hpzhaozhao/LZU_ASCENTO/dm-mc02-master/LCD模块/DM_TFT-V1.1.step

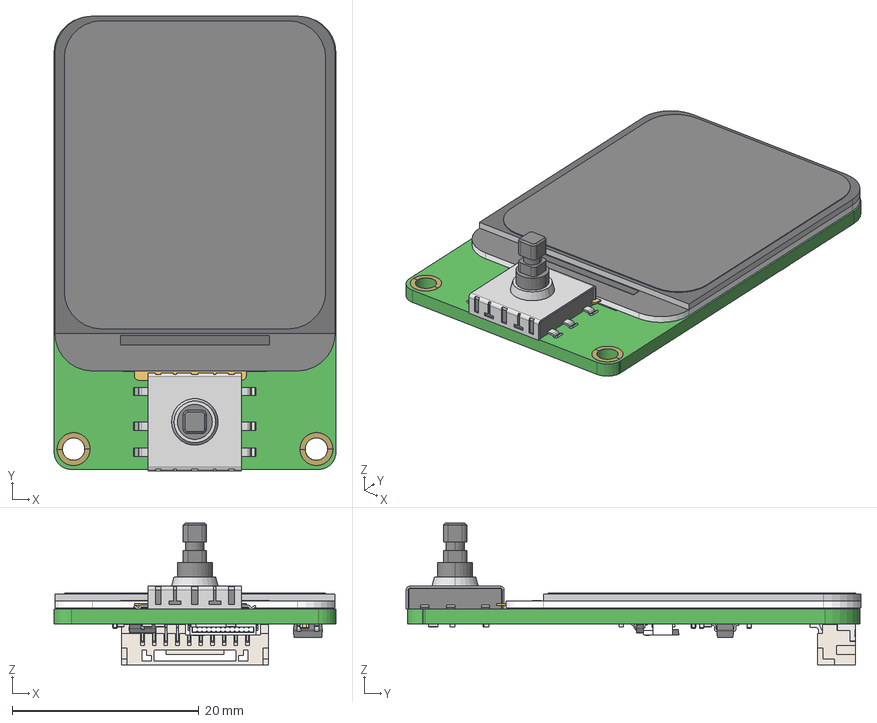
[picture p43: CAD file, 2026-05-26]
dm-mc02-master/LCD模块/DM_TFT-V1.1.step
30.2 x 48.7 x 15.2 mm
K1-1504SA-06 x 24
Extruded x 38
User Library-SOT23A
COMPOUND.step
R0402 x 12
sot-23-3-infineon
1.69¡± Round IPS x 57
SOLID.step
