hpzhaozhao/LZU_ASCENTO/答辩ppt/赵锦程答辩ppt.pdf

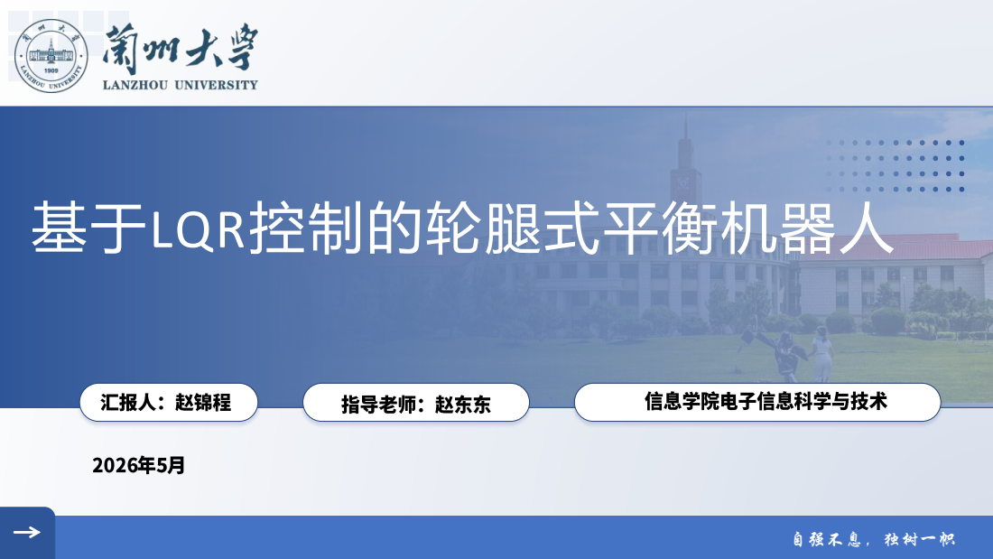
[picture p44: page 1]
基于LQR控制的轮腿式平衡机器人; 汇汇汇汇汇汇汇; 汇汇汇汇汇汇汇汇; 汇汇汇汇汇汇汇汇汇汇汇汇汇; 自强不息，独树一帜

1 | 选题背景和思路 2 | 机器人机械结构与硬件设计 3 | 机器人软件算法设计 4 | 实验验证与结果分析 5 | 总结与展望

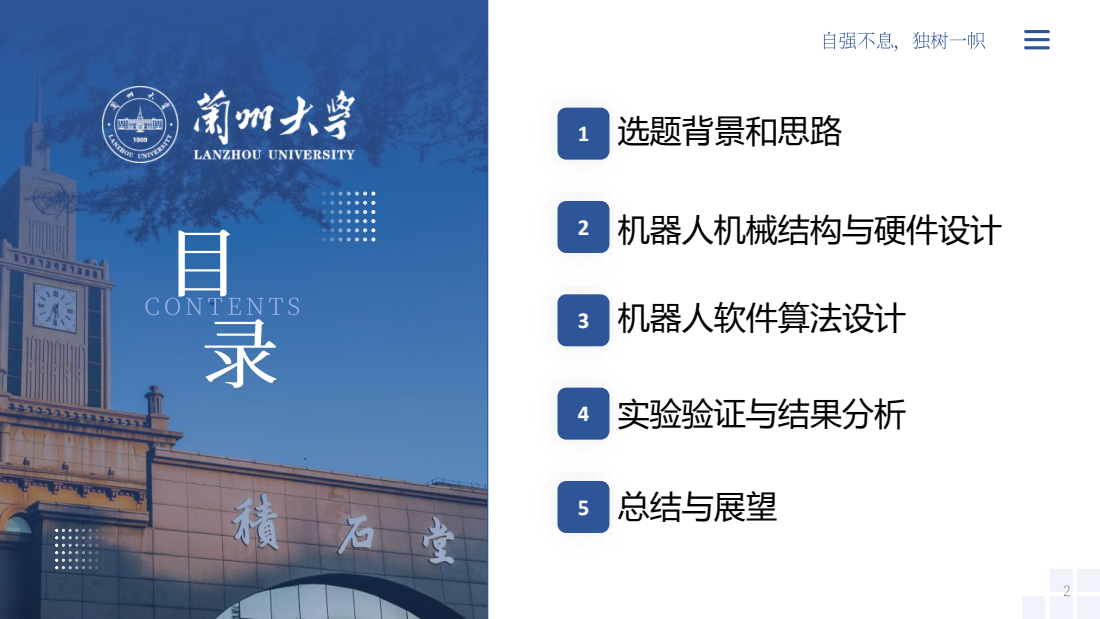
[picture p45: page 2]
汇汇汇汇; 汇 汇汇汇汇; CONTENTS

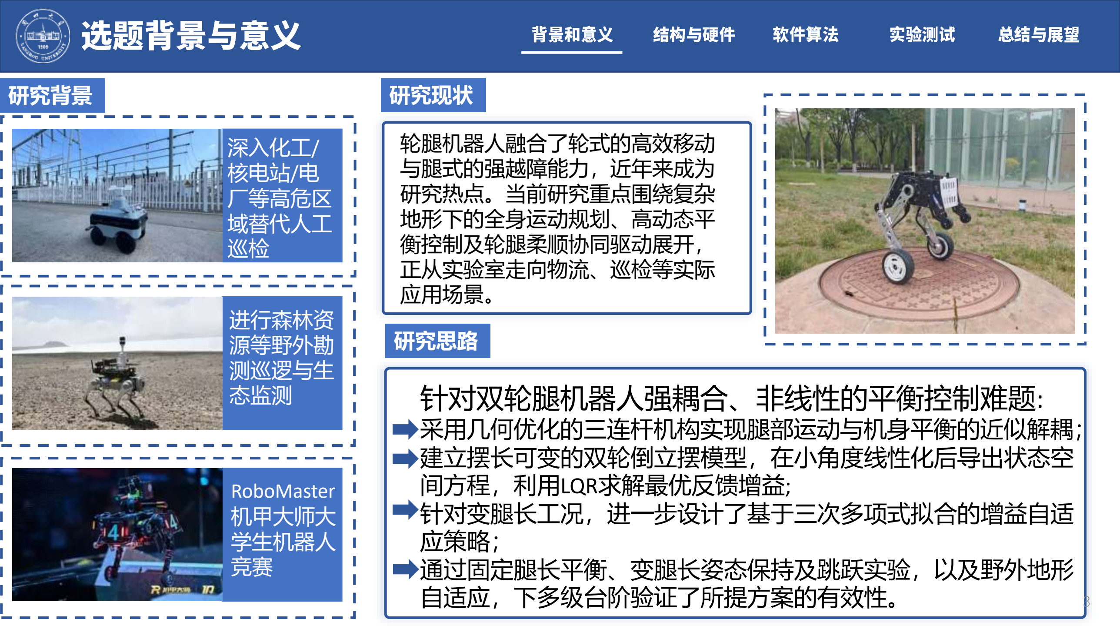
[picture p46: page 3]

汇汇汇汇汇汇汇 | 汇汇汇汇汇 | 汇汇汇汇汇 | 汇汇汇汇 | 汇汇汇汇 | 汇汇汇汇汇

研究背景

深入化工/
核电站/电
厂等高危区
域替代人工
巡检

进行森林资
源等野外勘
测巡逻与生
态监测

研究现状

研究思路

RoboMaster
机甲大师大
学生机器人
竞赛

轮腿机器人融合了轮式的高效移动
与腿式的强越障能力，近年来成为
研究热点。当前研究重点围绕复杂
地形下的全身运动规划、高动态平
衡控制及轮腿柔顺协同驱动展开，
正从实验室走向物流、巡检等实际
应用场景。

## 针对双轮腿机器人强耦合、非线性的平衡控制难题:

### 采用几何优化的三连杆机构实现腿部运动与机身平衡的近似解耦； 建立摆长可变的双轮倒立摆模型，在小角度线性化后导出状态空

间方程，利用LQR求解最优反馈增益;

### 针对变腿长工况，进一步设计了基于三次多项式拟合的增益自适 应策略； 通过固定腿长平衡、变腿长姿态保持及跳跃实验，以及野外地形 自适应，下多级台阶验证了所提方案的有效性。

## 机器人腿部结构解算

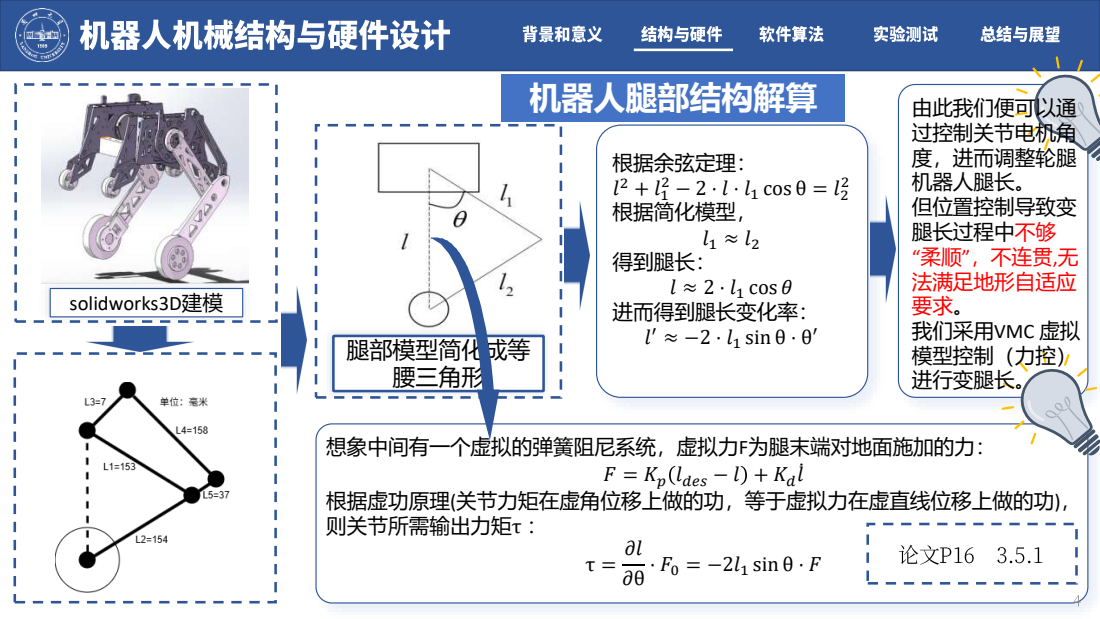
[picture p47: page 4]
2 − 2 ⋅ l ⋅ l1 cos θ = l2; 汇汇汇汇汇汇汇汇汇汇汇汇; 汇汇汇汇汇; 汇汇汇汇; solidworks3D建模; 腿部模型简化成等 腰三角形; 根据余弦定理： l; 根据简化模型， l1 ≈ l2 得到腿长： l ≈ 2 ⋅ l1 cos θ 进而得到腿长变化率： l; ′ ≈ −2 ⋅ l1 sin θ ⋅ θ; 由此我们便可以通 过控制关节电机角 度，进而调整轮腿 机器人腿长。 但位置控制导致变 腿长过程中不够 “柔顺”，不连贯,无 法满足地形自适应 要求。 我们采用VMC 虚拟 模型控制（力控） 进行变腿长。; 想象中间有一个虚拟的弹簧阻尼系统，虚拟力F为腿末端对地面施加的力： ሶ l; ∂l ∂θ ⋅ F0 = −2l1 sin θ ⋅ F

F = Kp ldes − l + Kd

根据虚功原理(关节力矩在虚角位移上做的功，等于虚拟力在虚直线位移上做的功)，
则关节所需输出力矩τ ：

## 整体硬件电路

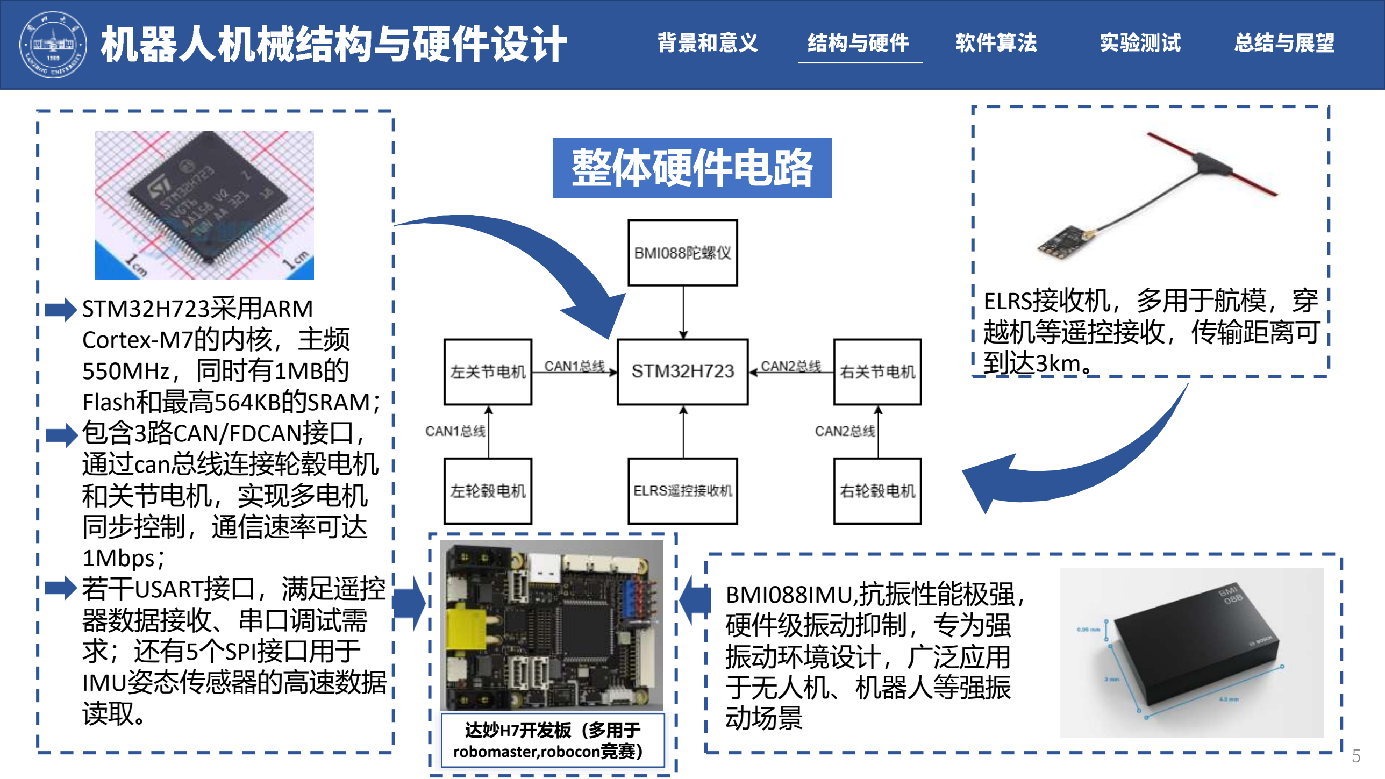
[picture p48: page 5]

汇汇汇汇汇汇汇汇汇汇汇汇 | 汇汇汇汇汇 | 汇汇汇汇汇 | 汇汇汇汇 | 汇汇汇汇 | 汇汇汇汇汇

STM32H723采用ARM
Cortex-M7的内核，主频
550MHz，同时有1MB的
Flash和最高564KB的SRAM；
包含3路CAN/FDCAN接口，
通过can总线连接轮毂电机
和关节电机，实现多电机
同步控制，通信速率可达
1Mbps；
若干USART接口，满足遥控
器数据接收、串口调试需
求；还有5个SPI接口用于
IMU姿态传感器的高速数据
读取。

ELRS接收机，多用于航模，穿
越机等遥控接收，传输距离可
到达3km。

BMI088IMU,抗振性能极强，
硬件级振动抑制，专为强
振动环境设计，广泛应用
于无人机、机器人等强振
达妙H7开发板（多用于 | 动场景

robomaster,robocon竞赛）

## LQR控制算法 (线性二次型调节器)

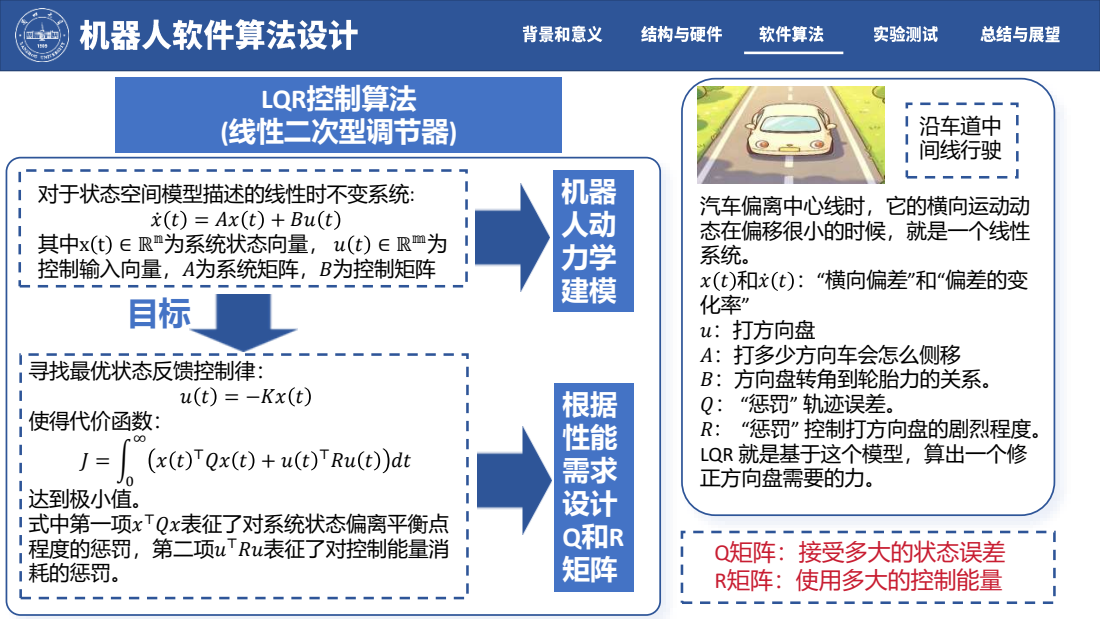
[picture p49: page 6]
对于状态空间模型描述的线性时不变系统:; 汇汇汇汇汇汇汇汇汇; 汇汇汇汇汇; 汇汇汇汇; Q矩阵：接受多大的状态误差 R矩阵：使用多大的控制能量; 寻找最优状态反馈控制律： u t = −Kx t; 使得代价函数： J = න; 达到极小值。 式中第一项x; ⊤Qx表征了对系统状态偏离平衡点 程度的惩罚，第二项u; ⊤Ru表征了对控制能量消; 耗的惩罚。; 根据 性能 需求 设计 Q和R 矩阵; 沿车道中 间线行驶

汽车偏离中心线时，它的横向运动动
态在偏移很小的时候，就是一个线性
x t 和xሶ t ：“横向偏差”和“偏差的变
u：打方向盘
A：打多少方向车会怎么侧移
B：方向盘转角到轮胎力的关系。
Q： “惩罚” 轨迹误差。
R汇 “惩罚” 控制打方向盘的剧烈程度。
LQR 就是基于这个模型，算出一个修
正方向盘需要的力。

其中x t ∈ ℝn为系统状态向量， u t ∈ ℝm为
控制输入向量，A为系统矩阵，B为控制矩阵

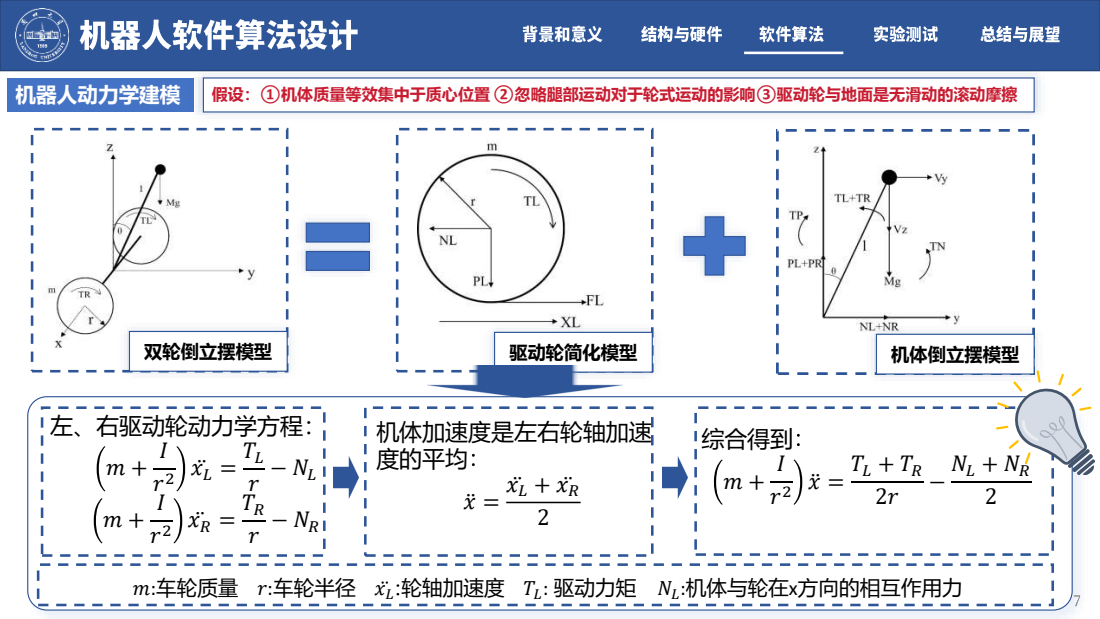
[picture p50: page 7]
2 − 2 ⋅ l ⋅ l1 cos θ = l2; 汇汇汇汇汇汇汇汇汇; 汇汇汇汇汇; 汇汇汇汇; 机器人动力学建模; 假设：①机体质量等效集中于质心位置②忽略腿部运动对于轮式运动的影响③驱动轮与地面是无滑动的滚动摩擦; 双轮倒立摆模型; 驱动轮简化模型; 机体倒立摆模型; 左、右驱动轮动力学方程：; xሷL =; xRሷ =; 机体加速度是左右轮轴加速 度的平均汇; xሷL + xRሷ 2; 综合得到汇; :轮轴加速度 TL; : 驱动力矩 NL; :机体与轮在x方向的相互作用力

m:车轮质量 r:车轮半径 xሷL

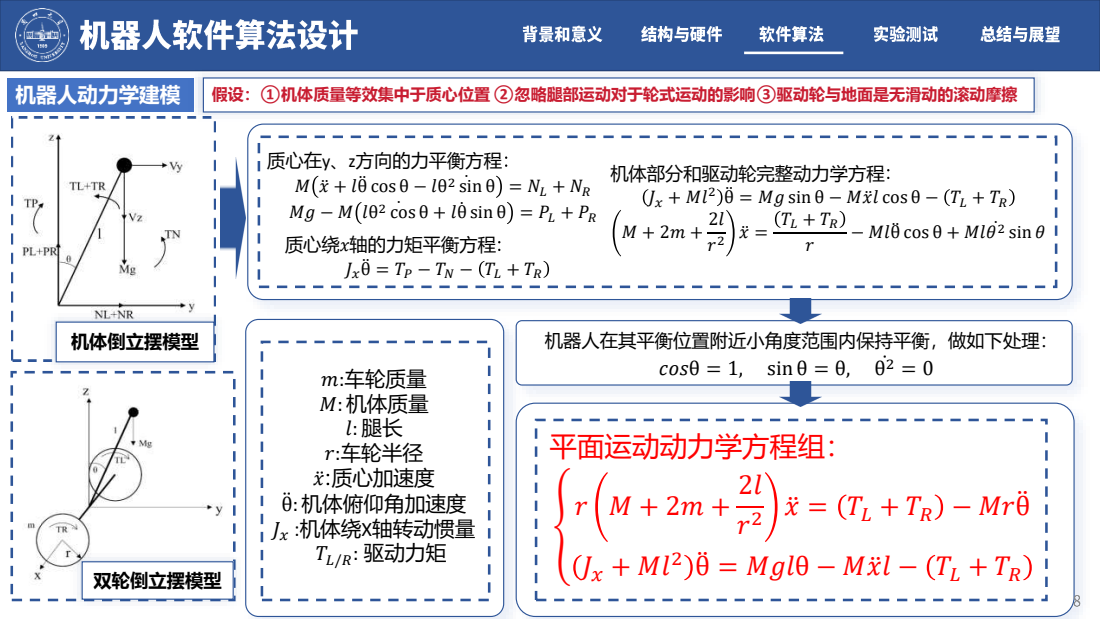
[picture p51: page 8]
汇汇汇汇汇汇汇汇汇; 汇汇汇汇汇; 汇汇汇汇; 机器人动力学建模; 假设：①机体质量等效集中于质心位置②忽略腿部运动对于轮式运动的影响③驱动轮与地面是无滑动的滚动摩擦; 机体倒立摆模型; m:车轮质量 M:机体质量 l:腿长 r:车轮半径 xሷ:质心加速度 θሷ: 机体俯仰角加速度 Jx :机体绕X轴转动惯量; TL/R: 驱动力矩; 质心在y、z方向的力平衡方程汇; xሷ+ lθሷcos θ − l; 机体部分和驱动轮完整动力学方程汇 Jx + Ml; − Mlθሷcos θ + Ml ሶ θ 2 sin θ; 机器人在其平衡位置附近小角度范围内保持平衡，做如下处理： cosθ = 1, sin θ = θ,; 平面运动动力学方程组： ൞; xሷ= TL + TR − Mrθሷ; 2 θሷ= Mglθ − Mxሷl − TL + TR

2 sin θ = NL + NR

2 θሷ= Mg sin θ − Mxሷl cos θ − TL + TR

2 cos θ + lθሶ sin θ = PL + PR

质心绕x轴的力矩平衡方程汇

Jxθሷ= TP − TN − TL + TR

Jx + Ml 双轮倒立摆模型

൞

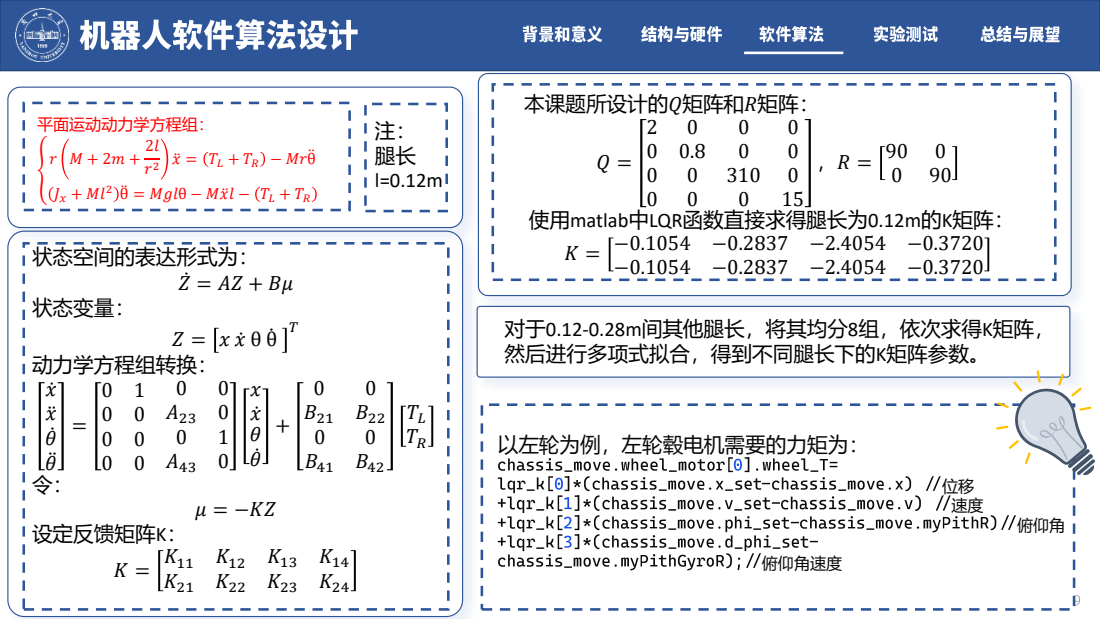
[picture p52: page 9]
汇汇汇汇汇汇汇汇汇; 汇汇汇汇汇; 汇汇汇汇; 平面运动动力学方程组：; xሷ= TL + TR − Mrθሷ; 2 θሷ= Mglθ − Mxሷl − TL + TR; 状态空间的表达形式为：; 状态变量：; 动力学方程组转换： xሶ xሷ θሶ θሷ; 设定反馈矩阵K：; 本课题所设计的Q矩阵和R矩阵：; 使用matlab中LQR函数直接求得腿长为0.12m的K矩阵：; 对于0.12-0.28m间其他腿长，将其均分8组，依次求得K矩阵， 然后进行多项式拟合，得到不同腿长下的K矩阵参数。; 以左轮为例，左轮毂电机需要的力矩为：; chassis_move.wheel_motor[; 0].wheel_T=; lqr_k[ 0]*(chassis_move.x_set; - chassis_move.x) //; +lqr_k[; 1]*(chassis_move.v_set; - chassis_move.v) //; 2]*(chassis_move.phi_set; - chassis_move.myPithR)//; 俯仰角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

## ROLL/横滚角抗

## 干扰+遥控测试

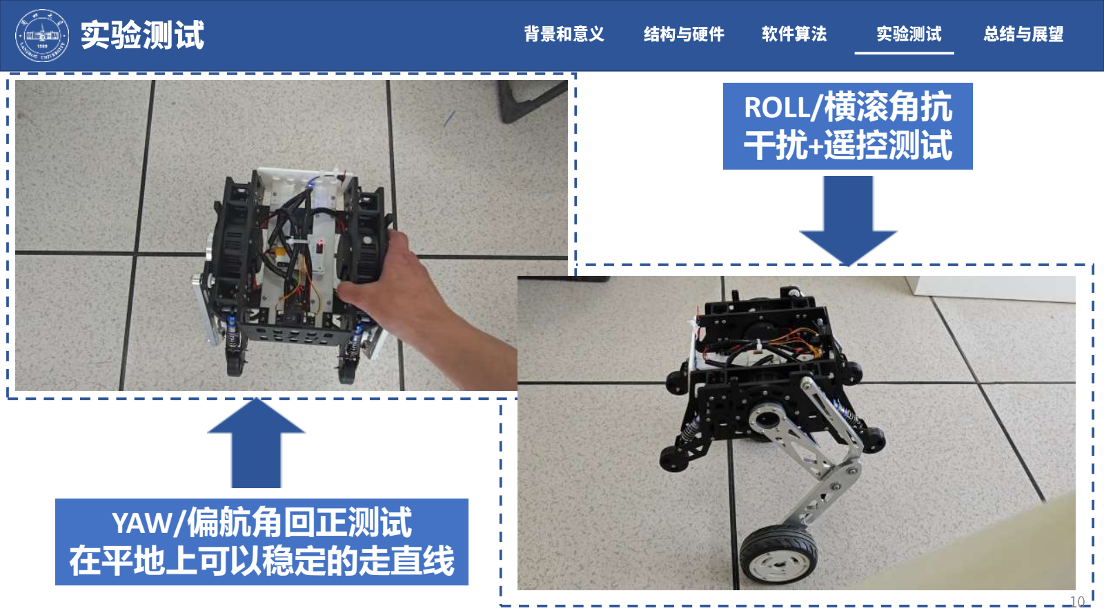
[picture p53: page 10]

汇汇汇汇 | 汇汇汇汇汇 | 汇汇汇汇汇 | 汇汇汇汇 | 汇汇汇汇 | 汇汇汇汇汇

## YAW/偏航角回正测试

## 在平地上可以稳定的走直线

# 室外静态/变腿

## 长平衡测试

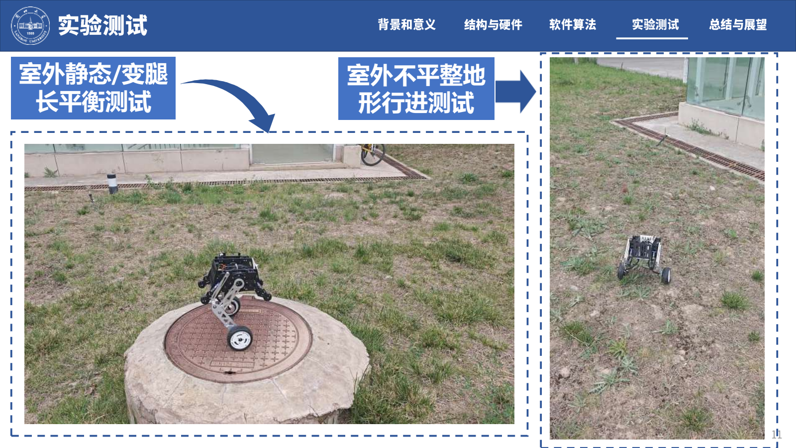
[picture p54: page 11]

汇汇汇汇 | 汇汇汇汇汇 | 汇汇汇汇汇 | 汇汇汇汇 | 汇汇汇汇 | 汇汇汇汇汇

# 室外不平整地

## 形行进测试

二/四级台阶 | 跳跃测试（慢动作）

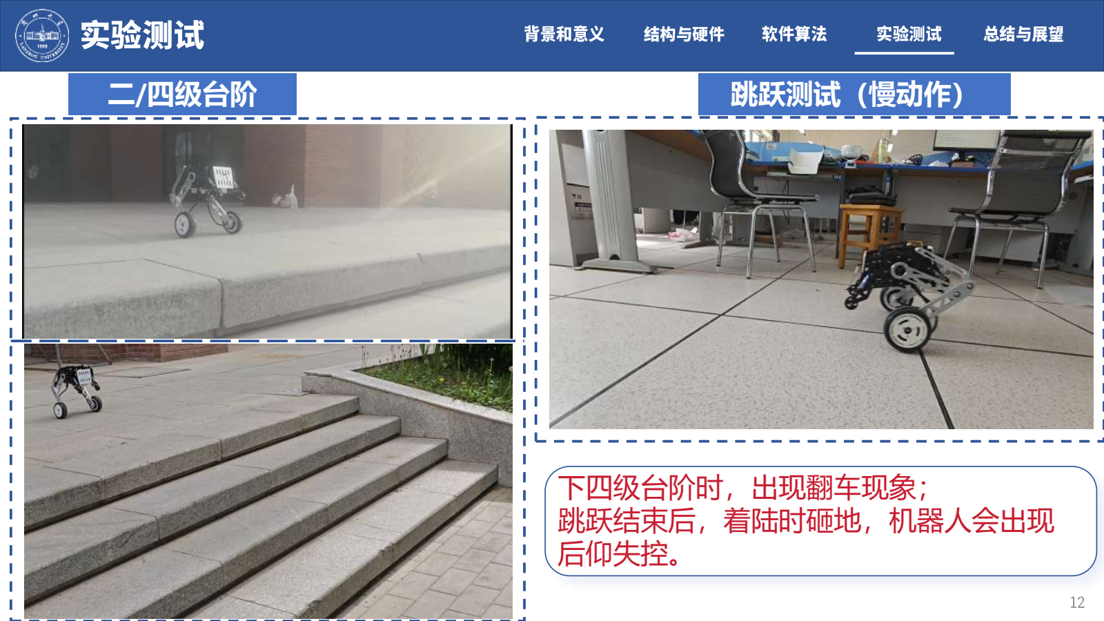
[picture p55: page 12]

l

2 + l1

2 − 2 ⋅ l cs θ l2

2

汇汇汇汇 | 汇汇汇汇汇 | 汇汇汇汇汇 | 汇汇汇汇 | 汇汇汇汇 | 汇汇汇汇汇

## 下四级台阶时，出现翻车现象；

## 跳跃结束后，着陆时砸地，机器人会出现 后仰失控。

汇汇汇汇汇 | 汇汇汇汇汇 | 汇汇汇汇汇 | 汇汇汇汇 | 汇汇汇汇 | 汇汇汇汇汇

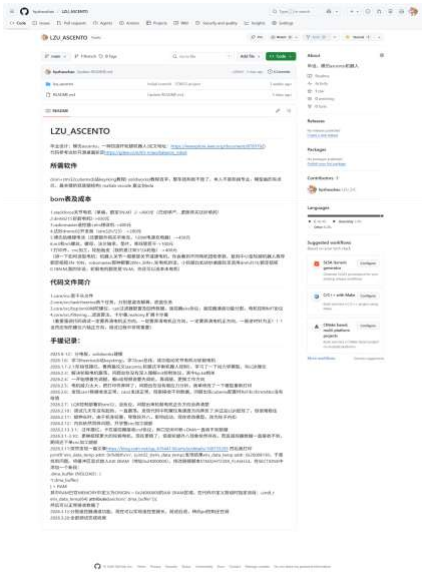
[picture p56: figure]

## 本课题基于LQR控制算法制作了一个相对完整的轮腿机

## 器人下位机平台，目前已经开源至Github

（ hpzhaozhao/LZU_ASCENTO: (https://github.com/hpzhaozhao/LZU_ASCENTO) 毕设，模仿 (https://github.com/hpzhaozhao/LZU_ASCENTO)ascento (https://github.com/hpzhaozhao/LZU_ASCENTO)机器人） (https://github.com/hpzhaozhao/LZU_ASCENTO)

## 可供其他开发者复刻，与上位机如RK3588、树莓派联合 开发，搭配上单目摄像头，激光雷达等传感器实现SLAM 建图、导航、路径规划、避障、目标检测众多功能。

不足：

## 1、在下多级台阶，跳跃场景下极易失控；

## 2、在室内平整地面，无法做到禁止不动，通过前后移 动保持平衡，可能原因可能是质心位置，机体转动惯

## 量不精确；

## 3、按理来说是忽略腿部质量进行控制，但本课题的腿 部是铝合金材质，质量占到整体的1/5，若强行忽略， 就会影响控制效果。

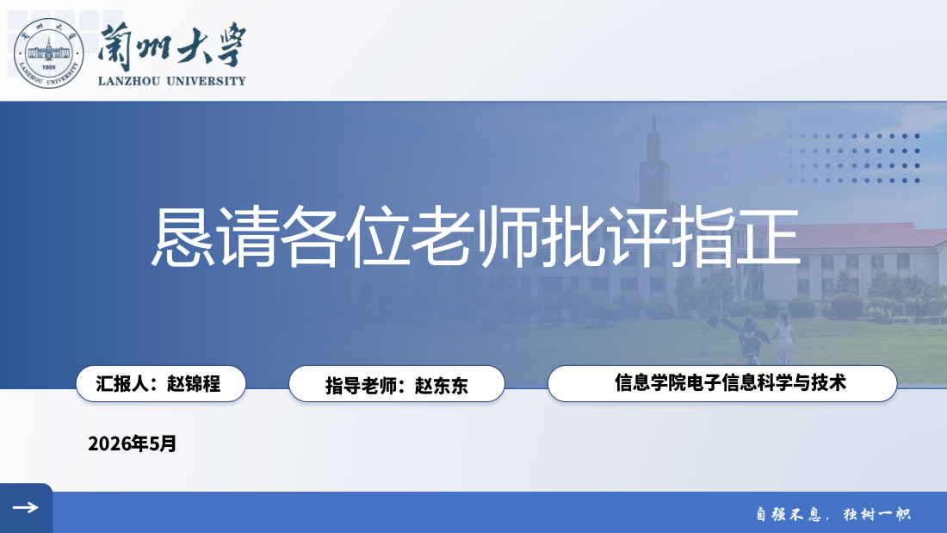
[picture p57: page 14]
恳请各位老师批评指正; 汇汇汇汇汇汇汇; 汇汇汇汇汇汇汇汇; 汇汇汇汇汇汇汇汇汇汇汇汇汇; 自强不息，独树一帜
