hpzhaozhao/LZU_ASCENTO/dm-mc02-master/原理图/CtrBoard-H7_V1.0-管脚标注图240127.pdf

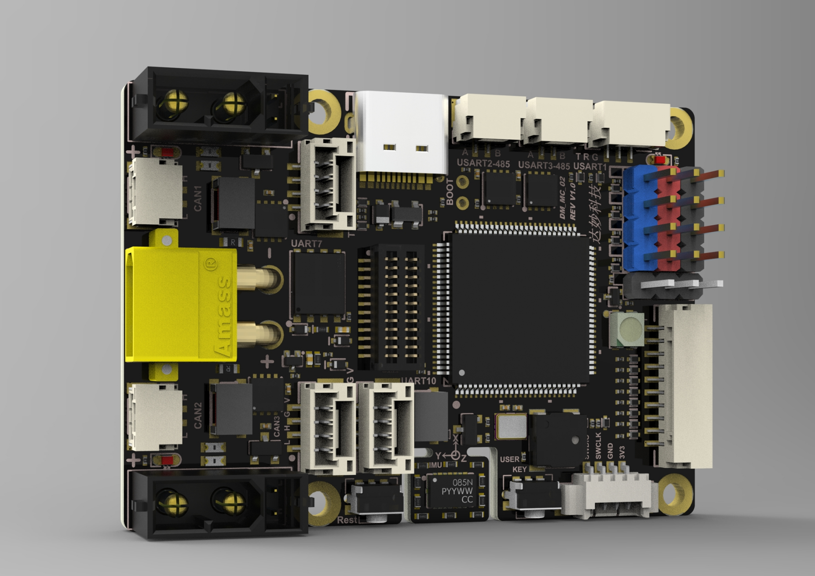
[picture p58: page 1]

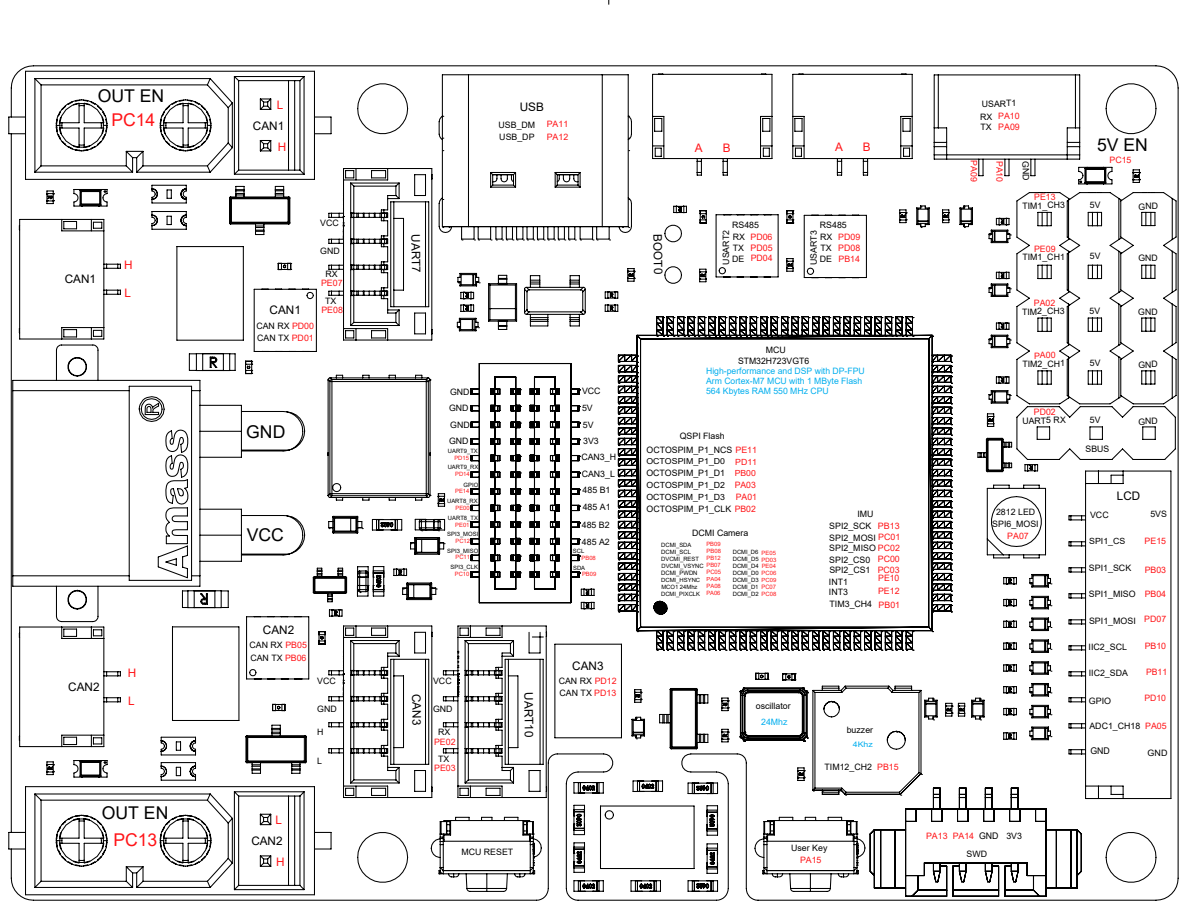
[picture p59: page 2]
OUT EN; CAN RX PD00 CAN TX PD01; CAN RX PB05 CAN TX PB06; 3 NAC; VCC HL; CAN RX CAN TX PD13; MCU RESET; User Key; PA13 PA14 GND 3V3; SPI1_MISO PB04; SPI1_SCK PB03; SPI1_MOSI PD07; ADC1_CH18 PA05; TIM12_CH2 PB15; QSPI Flash OCTOSPIM_P1_NCS PE11 OCTOSPIM_P1_D0 PD11 OCTOSPIM_P1_D1 PB00; OCTOSPIM_P1_D3 PA01; OCTOSPIM_P1_CLK PB02 0T OOB; USB_DM PA11 USB_DP PA12; USART2 RS485; USART3 RS485; DNG TIM1_CH3 5V GND; 5V GND; UART5 RX; 2812 LED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

OUT EN LH

MCU
STM32H723VGT6
High-performance and DSP with DP-FPU
Arm Cortex-M7 MCU with 1 MByte Flash
564 Kbytes RAM 550 MHz CPU
