hpzhaozhao/LZU_ASCENTO/lzu_ascento/Core/Src/main.c

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
/* Includes ------------------------------------------------------------------*/
#include "main.h"
#include "cmsis_os.h"
#include "dma.h"
#include "fdcan.h"
#include "memorymap.h"
#include "spi.h"
#include "usart.h"
#include "gpio.h"

/* USER CODE BEGIN Includes */
#include "bmi088driver.h"
// #include "kalman_filter.h"
// #include "mahony_filter.h"
#include "bsp_dwt.h"
#include "bmi088midware.h"
#include "can_bsp.h"
#include "tjc_usart_hmi.h"
#include "elrs.h"
#include "string.h"
/* USER CODE END Includes */


void SystemClock_Config(void);
void PeriphCommonClock_Config(void);
void MX_FREERTOS_Init(void);
/* USER CODE BEGIN 0 */
// 假设使用USART2，根据实际情况修改


// // 重定向printf
// int __io_putchar(int ch) {
//   HAL_UART_Transmit(&huart7, (uint8_t *)&ch, 1, HAL_MAX_DELAY);
//   return ch;
// }


uint8_t Rx_data[200] = {0};
char received_string[256];
extern DMA_HandleTypeDef hdma_uart7_rx;
extern DMA_HandleTypeDef hdma_usart10_rx;
void HAL_UARTEx_RxEventCallback(UART_HandleTypeDef *huart, uint16_t Size)
{
  if (huart == &huart7)
  {
    strcpy(received_string, (char *)Rx_data);
    fprintf(stdout, "%s\r\n", received_string);
    memset(Rx_data, 0, sizeof(Rx_data));
    HAL_UARTEx_ReceiveToIdle_DMA(huart, Rx_data, sizeof(Rx_data) - 1);
    __HAL_DMA_DISABLE_IT(&hdma_uart7_rx, DMA_IT_HT);
  }
  else if (huart == &huart10)
  {
    ELRS_UARTE_RxCallback(Size);
    // HAL_GPIO_TogglePin(GPIOF, GPIO_PIN_10);
  }
}

void HAL_UART_ErrorCallback(UART_HandleTypeDef *huart)
  {
    if (huart == &huart10) {
      // 1. 停止 DMA 接收
      HAL_UART_DMAStop(&huart10);
      // 2. 清除 UART 错误标志（读 SR 再读 DR）
      __HAL_UART_CLEAR_FLAG(&huart10, UART_CLEAR_OREF | UART_CLEAR_NEF | UART_CLEAR_PEF | UART_CLEAR_FEF);
      // 3. 清除 DMA 流错误（如果有）
      __HAL_DMA_CLEAR_FLAG(&hdma_usart10_rx, __HAL_DMA_GET_TC_FLAG_INDEX(&hdma_usart10_rx) |
                            __HAL_DMA_GET_HT_FLAG_INDEX(&hdma_usart10_rx) |
                            __HAL_DMA_GET_TE_FLAG_INDEX(&hdma_usart10_rx) |
                            __HAL_DMA_GET_DME_FLAG_INDEX(&hdma_usart10_rx) |
                            __HAL_DMA_GET_FE_FLAG_INDEX(&hdma_usart10_rx));
      // 4. 重新启动 DMA 空闲中断接收
      HAL_UARTEx_ReceiveToIdle_DMA(&huart10, elrs_data_temp, MAX_FRAME_SIZE);
      __HAL_DMA_DISABLE_IT(&hdma_usart10_rx, DMA_IT_HT);  // 可选
    }
  }

/* USER CODE END 0 */

/**
  * @brief  The application entry point.
  * @retval int
  */
int main(void)
{

  /* MCU Configuration--------------------------------------------------------*/

  /* Reset of all peripherals, Initializes the Flash interface and the Systick. */
  HAL_Init();

  /* Configure the system clock */
  SystemClock_Config();

  /* Configure the peripherals common clocks */
  PeriphCommonClock_Config();

  /* Initialize all configured peripherals */
  MX_GPIO_Init();
  MX_DMA_Init();
  MX_FDCAN1_Init();
  MX_FDCAN2_Init();
  MX_SPI2_Init();
  MX_USART10_UART_Init();
  MX_UART7_Init();
  /* USER CODE BEGIN 2 */
  start_duipin();//imu初始化完成，可控电源打开，led灯亮
  HAL_UARTEx_ReceiveToIdle_DMA(&huart7, Rx_data, 200 - 1);
  __HAL_DMA_DISABLE_IT(&hdma_uart7_rx, DMA_IT_HT);
  ELRS_Init();
  DWT_Init(480);
  while (BMI088_init(&hspi2, 0) != BMI088_NO_ERROR)
  {
    ;
  }
  //initRingBuffer();
  //HAL_UART_Receive_IT(&TJC_UART, RxBuffer, 1);
  FDCAN1_Config();//can过滤器初始化
  FDCAN2_Config();
  /* USER CODE END 2 */

  /* Call init function for freertos objects (in cmsis_os2.c) */
  MX_FREERTOS_Init();

  /* Start scheduler */
  osKernelStart();

  /* We should never get here as control is now taken by the scheduler */

  /* Infinite loop */
  /* USER CODE BEGIN WHILE */
  while (1)
  {
    /* USER CODE END WHILE */

    /* USER CODE BEGIN 3 */
  }
  /* USER CODE END 3 */
}

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
/**
  * @brief  Period elapsed callback in non blocking mode
  * @note   This function is called  when TIM2 interrupt took place, inside
  * HAL_TIM_IRQHandler(). It makes a direct call to HAL_IncTick() to increment
  * a global variable "uwTick" used as application time base.
  * @param  htim : TIM handle
  * @retval None
  */
void HAL_TIM_PeriodElapsedCallback(TIM_HandleTypeDef *htim)
{
  if (htim->Instance == TIM2)
  {
    HAL_IncTick();
  }
}

/**
  * @brief  This function is executed in case of error occurrence.
  * @retval None
  */
void Error_Handler(void)
{
  /* USER CODE BEGIN Error_Handler_Debug */
  /* User can add his own implementation to report the HAL error return state */
  __disable_irq();
  while (1)
  {
  }
  /* USER CODE END Error_Handler_Debug */
}

#ifdef  USE_FULL_ASSERT
/**
  * @brief  Reports the name of the source file and the source line number
  *         where the assert_param error has occurred.
  * @param  file: pointer to the source file name
  * @param  line: assert_param error line source number
  * @retval None
  */
void assert_failed(uint8_t *file, uint32_t line)
{
  /* USER CODE BEGIN 6 */
  /* User can add his own implementation to report the file name and line number,
     ex: printf("Wrong parameters value: file %s on line %d\r\n", file, line) */
  /* USER CODE END 6 */
}
#endif /* USE_FULL_ASSERT */
