hpzhaozhao/LZU_ASCENTO/lzu_ascento/lzu_ascento.ioc

Mcu.UserName=STM32H723VGTx
PA13(JTMS/SWDIO).Signal=DEBUG_JTMS-SWDIO
PA14(JTCK/SWCLK).Signal=DEBUG_JTCK-SWCLK
PB13.Signal=SPI2_SCK
PB5.Signal=FDCAN2_RX
PB6.Signal=FDCAN2_TX
PC0.GPIO_Label=ACC_CS
PC0.Signal=GPIO_Output
PC1.Signal=SPI2_MOSI
PC13.Signal=GPIO_Output
PC15-OSC32_OUT.Signal=GPIO_Output
PC2_C.Signal=SPI2_MISO
PC3_C.GPIO_Label=GYRO_CS
PC3_C.Signal=GPIO_Output
PD0.Signal=FDCAN1_RX
PD1.Signal=FDCAN1_TX
PE10.GPIO_Label=ACC_INT
PE10.Signal=GPXTI10
PE12.GPIO_Label=GYRO_INT
PE12.Signal=GPXTI12
PE13.GPIO_Label=CLK
PE13.Signal=GPIO_Output
PE2.Signal=USART10_RX
PE3.Signal=USART10_TX
PE7.Signal=UART7_RX
PE8.Signal=UART7_TX
PE9.GPIO_Label=CS
PE9.Signal=GPIO_Output
PH0-OSC_IN.Signal=RCC_OSC_IN
PH1-OSC_OUT.Signal=RCC_OSC_OUT
