hpzhaozhao/LZU_ASCENTO/lzu_ascento/Core/Inc/main.h

#define ACC_CS_Pin GPIO_PIN_0
#define ACC_CS_GPIO_Port GPIOC
#define GYRO_CS_Pin GPIO_PIN_3
#define GYRO_CS_GPIO_Port GPIOC
#define CS_Pin GPIO_PIN_9
#define CS_GPIO_Port GPIOE
#define ACC_INT_Pin GPIO_PIN_10
#define ACC_INT_GPIO_Port GPIOE
#define GYRO_INT_Pin GPIO_PIN_12
#define GYRO_INT_GPIO_Port GPIOE
#define CLK_Pin GPIO_PIN_13
#define CLK_GPIO_Port GPIOE
