hpzhaozhao/LZU_ASCENTO/lzu_ascento/Core/Src/usart.c

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
/* Includes ------------------------------------------------------------------*/
#include "usart.h"

/* USER CODE BEGIN 0 */
#ifdef __GNUC__
#define PUTCHAR_PROTOTYPE int __io_putchar(int ch)
#else
#define PUTCHAR_PROTOTYPE int fputc(int ch, FILE *f)
#endif

PUTCHAR_PROTOTYPE
{
  HAL_UART_Transmit(&huart7, (uint8_t *) &ch, 1, HAL_MAX_DELAY);
  return ch;
}
/* USER CODE END 0 */

UART_HandleTypeDef huart7;
UART_HandleTypeDef huart10;
DMA_HandleTypeDef hdma_uart7_rx;
DMA_HandleTypeDef hdma_uart7_tx;
DMA_HandleTypeDef hdma_usart10_rx;

/* UART7 init function */
void MX_UART7_Init(void)
{

  huart7.Instance = UART7;
  huart7.Init.BaudRate = 115200;
  huart7.Init.WordLength = UART_WORDLENGTH_8B;
  huart7.Init.StopBits = UART_STOPBITS_1;
  huart7.Init.Parity = UART_PARITY_NONE;
  huart7.Init.Mode = UART_MODE_TX_RX;
  huart7.Init.HwFlowCtl = UART_HWCONTROL_NONE;
  huart7.Init.OverSampling = UART_OVERSAMPLING_16;
  huart7.Init.OneBitSampling = UART_ONE_BIT_SAMPLE_DISABLE;
  huart7.Init.ClockPrescaler = UART_PRESCALER_DIV1;
  huart7.AdvancedInit.AdvFeatureInit = UART_ADVFEATURE_NO_INIT;
  if (HAL_UART_Init(&huart7) != HAL_OK)
  {
    Error_Handler();
  }
  if (HAL_UARTEx_SetTxFifoThreshold(&huart7, UART_TXFIFO_THRESHOLD_1_8) != HAL_OK)
  {
    Error_Handler();
  }
  if (HAL_UARTEx_SetRxFifoThreshold(&huart7, UART_RXFIFO_THRESHOLD_1_8) != HAL_OK)
  {
    Error_Handler();
  }
  if (HAL_UARTEx_DisableFifoMode(&huart7) != HAL_OK)
  {
    Error_Handler();
  }
}
/* USART10 init function */

void MX_USART10_UART_Init(void)
{

  huart10.Instance = USART10;
  huart10.Init.BaudRate = 420000;
  huart10.Init.WordLength = UART_WORDLENGTH_8B;
  huart10.Init.StopBits = UART_STOPBITS_1;
  huart10.Init.Parity = UART_PARITY_NONE;
  huart10.Init.Mode = UART_MODE_TX_RX;
  huart10.Init.HwFlowCtl = UART_HWCONTROL_NONE;
  huart10.Init.OverSampling = UART_OVERSAMPLING_16;
  huart10.Init.OneBitSampling = UART_ONE_BIT_SAMPLE_DISABLE;
  huart10.Init.ClockPrescaler = UART_PRESCALER_DIV1;
  huart10.AdvancedInit.AdvFeatureInit = UART_ADVFEATURE_NO_INIT;
  if (HAL_UART_Init(&huart10) != HAL_OK)
  {
    Error_Handler();
  }
  if (HAL_UARTEx_SetTxFifoThreshold(&huart10, UART_TXFIFO_THRESHOLD_1_8) != HAL_OK)
  {
    Error_Handler();
  }
  if (HAL_UARTEx_SetRxFifoThreshold(&huart10, UART_RXFIFO_THRESHOLD_1_8) != HAL_OK)
  {
    Error_Handler();
  }
  if (HAL_UARTEx_DisableFifoMode(&huart10) != HAL_OK)
  {
    Error_Handler();
  }
  /* USER CODE BEGIN USART10_Init 2 */
  // 启用 FIFO 模式
  HAL_UARTEx_EnableFifoMode(&huart10);
  // 设置接收 FIFO 阈值为 1/2（即接收到一半触发 DMA 请求）
  HAL_UARTEx_SetRxFifoThreshold(&huart10, UART_RXFIFO_THRESHOLD_1_2);
  // 发送 FIFO 阈值可默认
  HAL_UARTEx_SetTxFifoThreshold(&huart10, UART_TXFIFO_THRESHOLD_1_8);
  /* USER CODE END USART10_Init 2 */

}

void HAL_UART_MspInit(UART_HandleTypeDef* uartHandle)
{

  GPIO_InitTypeDef GPIO_InitStruct = {0};
  RCC_PeriphCLKInitTypeDef PeriphClkInitStruct = {0};
  if(uartHandle->Instance==UART7)
  {
  /** Initializes the peripherals clock
  */
    PeriphClkInitStruct.PeriphClockSelection = RCC_PERIPHCLK_UART7;
    PeriphClkInitStruct.Usart234578ClockSelection = RCC_USART234578CLKSOURCE_D2PCLK1;
    if (HAL_RCCEx_PeriphCLKConfig(&PeriphClkInitStruct) != HAL_OK)
    {
      Error_Handler();
    }

    /* UART7 clock enable */
    __HAL_RCC_UART7_CLK_ENABLE();

    __HAL_RCC_GPIOE_CLK_ENABLE();
    /**UART7 GPIO Configuration
    PE7     ------> UART7_RX
    PE8     ------> UART7_TX
    */
    GPIO_InitStruct.Pin = GPIO_PIN_7|GPIO_PIN_8;
    GPIO_InitStruct.Mode = GPIO_MODE_AF_PP;
    GPIO_InitStruct.Pull = GPIO_NOPULL;
    GPIO_InitStruct.Speed = GPIO_SPEED_FREQ_LOW;
    GPIO_InitStruct.Alternate = GPIO_AF7_UART7;
    HAL_GPIO_Init(GPIOE, &GPIO_InitStruct);

    /* UART7 DMA Init */
    /* UART7_RX Init */
    hdma_uart7_rx.Instance = DMA1_Stream3;
    hdma_uart7_rx.Init.Request = DMA_REQUEST_UART7_RX;
    hdma_uart7_rx.Init.Direction = DMA_PERIPH_TO_MEMORY;
    hdma_uart7_rx.Init.PeriphInc = DMA_PINC_DISABLE;
    hdma_uart7_rx.Init.MemInc = DMA_MINC_ENABLE;
    hdma_uart7_rx.Init.PeriphDataAlignment = DMA_PDATAALIGN_BYTE;
    hdma_uart7_rx.Init.MemDataAlignment = DMA_MDATAALIGN_BYTE;
    hdma_uart7_rx.Init.Mode = DMA_NORMAL;
    hdma_uart7_rx.Init.Priority = DMA_PRIORITY_LOW;
    hdma_uart7_rx.Init.FIFOMode = DMA_FIFOMODE_DISABLE;
    if (HAL_DMA_Init(&hdma_uart7_rx) != HAL_OK)
    {
      Error_Handler();
    }

    __HAL_LINKDMA(uartHandle,hdmarx,hdma_uart7_rx);

    /* UART7_TX Init */
    hdma_uart7_tx.Instance = DMA1_Stream4;
    hdma_uart7_tx.Init.Request = DMA_REQUEST_UART7_TX;
    hdma_uart7_tx.Init.Direction = DMA_MEMORY_TO_PERIPH;
    hdma_uart7_tx.Init.PeriphInc = DMA_PINC_DISABLE;
    hdma_uart7_tx.Init.MemInc = DMA_MINC_ENABLE;
    hdma_uart7_tx.Init.PeriphDataAlignment = DMA_PDATAALIGN_BYTE;
    hdma_uart7_tx.Init.MemDataAlignment = DMA_MDATAALIGN_BYTE;
    hdma_uart7_tx.Init.Mode = DMA_NORMAL;
    hdma_uart7_tx.Init.Priority = DMA_PRIORITY_LOW;
    hdma_uart7_tx.Init.FIFOMode = DMA_FIFOMODE_DISABLE;
    if (HAL_DMA_Init(&hdma_uart7_tx) != HAL_OK)
    {
      Error_Handler();
    }

    __HAL_LINKDMA(uartHandle,hdmatx,hdma_uart7_tx);

    /* UART7 interrupt Init */
    HAL_NVIC_SetPriority(UART7_IRQn, 5, 0);
    HAL_NVIC_EnableIRQ(UART7_IRQn);
  }
  else if(uartHandle->Instance==USART10)
  {
  /** Initializes the peripherals clock
  */
    PeriphClkInitStruct.PeriphClockSelection = RCC_PERIPHCLK_USART10;
    PeriphClkInitStruct.Usart16ClockSelection = RCC_USART16910CLKSOURCE_D2PCLK2;
    if (HAL_RCCEx_PeriphCLKConfig(&PeriphClkInitStruct) != HAL_OK)
    {
      Error_Handler();
    }

    /* USART10 clock enable */
    __HAL_RCC_USART10_CLK_ENABLE();

    __HAL_RCC_GPIOE_CLK_ENABLE();
    /**USART10 GPIO Configuration
    PE2     ------> USART10_RX
    PE3     ------> USART10_TX
    */
    GPIO_InitStruct.Pin = GPIO_PIN_2;
    GPIO_InitStruct.Mode = GPIO_MODE_AF_PP;
    GPIO_InitStruct.Pull = GPIO_NOPULL;
    GPIO_InitStruct.Speed = GPIO_SPEED_FREQ_LOW;
    GPIO_InitStruct.Alternate = GPIO_AF4_USART10;
    HAL_GPIO_Init(GPIOE, &GPIO_InitStruct);

    GPIO_InitStruct.Pin = GPIO_PIN_3;
    GPIO_InitStruct.Mode = GPIO_MODE_AF_PP;
    GPIO_InitStruct.Pull = GPIO_NOPULL;
    GPIO_InitStruct.Speed = GPIO_SPEED_FREQ_LOW;
    GPIO_InitStruct.Alternate = GPIO_AF11_USART10;
    HAL_GPIO_Init(GPIOE, &GPIO_InitStruct);

    /* USART10 DMA Init */
    /* USART10_RX Init */
    hdma_usart10_rx.Instance = DMA1_Stream2;
    hdma_usart10_rx.Init.Request = DMA_REQUEST_USART10_RX;
    hdma_usart10_rx.Init.Direction = DMA_PERIPH_TO_MEMORY;
    hdma_usart10_rx.Init.PeriphInc = DMA_PINC_DISABLE;
    hdma_usart10_rx.Init.MemInc = DMA_MINC_ENABLE;
    hdma_usart10_rx.Init.PeriphDataAlignment = DMA_PDATAALIGN_BYTE;
    hdma_usart10_rx.Init.MemDataAlignment = DMA_MDATAALIGN_BYTE;
    hdma_usart10_rx.Init.Mode = DMA_NORMAL;
    hdma_usart10_rx.Init.Priority = DMA_PRIORITY_VERY_HIGH;
    hdma_usart10_rx.Init.FIFOMode = DMA_FIFOMODE_DISABLE;
    if (HAL_DMA_Init(&hdma_usart10_rx) != HAL_OK)
    {
      Error_Handler();
    }

    __HAL_LINKDMA(uartHandle,hdmarx,hdma_usart10_rx);

    /* USART10 interrupt Init */
    HAL_NVIC_SetPriority(USART10_IRQn, 5, 0);
    HAL_NVIC_EnableIRQ(USART10_IRQn);
  }
}

void HAL_UART_MspDeInit(UART_HandleTypeDef* uartHandle)
{

  if(uartHandle->Instance==UART7)
  {
    /* Peripheral clock disable */
    __HAL_RCC_UART7_CLK_DISABLE();

    /**UART7 GPIO Configuration
    PE7     ------> UART7_RX
    PE8     ------> UART7_TX
    */
    HAL_GPIO_DeInit(GPIOE, GPIO_PIN_7|GPIO_PIN_8);

    /* UART7 DMA DeInit */
    HAL_DMA_DeInit(uartHandle->hdmarx);
    HAL_DMA_DeInit(uartHandle->hdmatx);

    /* UART7 interrupt Deinit */
    HAL_NVIC_DisableIRQ(UART7_IRQn);
  }
  else if(uartHandle->Instance==USART10)
  {
    /* Peripheral clock disable */
    __HAL_RCC_USART10_CLK_DISABLE();

    /**USART10 GPIO Configuration
    PE2     ------> USART10_RX
    PE3     ------> USART10_TX
    */
    HAL_GPIO_DeInit(GPIOE, GPIO_PIN_2|GPIO_PIN_3);

    /* USART10 DMA DeInit */
    HAL_DMA_DeInit(uartHandle->hdmarx);

    /* USART10 interrupt Deinit */
    HAL_NVIC_DisableIRQ(USART10_IRQn);
  }
}
