hpzhaozhao/LZU_ASCENTO/lzu_ascento/Core/Src/task/INS_task.c

//
// Created by Z on 26-1-5.
//
/**
  *********************************************************************
  * @file      INS_task.c/h
  * @brief     该任务是用mahony方法获取机体姿态
  * @note
  * @history
  *
  @verbatim
  ==============================================================================

  ==============================================================================
  @endverbatim
  *********************************************************************
  */


#include "INS_task.h"
#include "QuaternionEKF.h"
#include "bsp_dwt.h"
#include "mahony_filter.h"
#include "cmsis_os.h"
#include "tjc_usart_hmi.h"
INS_t INS;

struct MAHONY_FILTER_t mahony;
Axis3f Gyro,Accel;
float gravity[3] = {0, 0, 9.81f};

uint32_t INS_DWT_Count = 0;
float ins_dt = 0.0f;
float ins_time;
int stop_time;



void INS_Init(void)
{
	 mahony_init(&mahony,1.0f,0.0f,0.001f);
   INS.AccelLPF = 0.0089f;
}

void INS_task(void)
{
	 INS_Init();

	 while(1)
	 {
		ins_dt = DWT_GetDeltaT(&INS_DWT_Count);

		mahony.dt = ins_dt;

    BMI088_Read(&BMI088);

    INS.Accel[X1] = BMI088.Accel[X1];
    INS.Accel[Y1] = BMI088.Accel[Y1];
    INS.Accel[Z1] = BMI088.Accel[Z1];
	  Accel.x=BMI088.Accel[0];
	  Accel.y=BMI088.Accel[1];
		Accel.z=BMI088.Accel[2];
    INS.Gyro[X1] = BMI088.Gyro[X1];
    INS.Gyro[Y1] = BMI088.Gyro[Y1];
    INS.Gyro[Z1] = BMI088.Gyro[Z1];
  	Gyro.x=BMI088.Gyro[0];
		Gyro.y=BMI088.Gyro[1];
		Gyro.z=BMI088.Gyro[2];

		mahony_input(&mahony,Gyro,Accel);
		mahony_update(&mahony);
		mahony_output(&mahony);
	  RotationMatrix_update(&mahony);

		INS.q[0]=mahony.q0;
		INS.q[1]=mahony.q1;
		INS.q[2]=mahony.q2;
		INS.q[3]=mahony.q3;

      // 将重力从导航坐标系n转换到机体系b,随后根据加速度计数据计算运动加速度
		float gravity_b[3];
    EarthFrameToBodyFrame(gravity, gravity_b, INS.q);
    for (uint8_t i = 0; i < 3; i++) // 同样过一个低通滤波
    {
      INS.MotionAccel_b[i] = (INS.Accel[i] - gravity_b[i]) * ins_dt / (INS.AccelLPF + ins_dt)
														+ INS.MotionAccel_b[i] * INS.AccelLPF / (INS.AccelLPF + ins_dt);
//			INS.MotionAccel_b[i] = (INS.Accel[i] ) * dt / (INS.AccelLPF + dt)
//														+ INS.MotionAccel_b[i] * INS.AccelLPF / (INS.AccelLPF + dt);
		}
		BodyFrameToEarthFrame(INS.MotionAccel_b, INS.MotionAccel_n, INS.q); // 转换回导航系n

		//死区处理
		if(fabsf(INS.MotionAccel_n[0])<0.02f)
		{
		  INS.MotionAccel_n[0]=0.0f;	//x轴
		}
		if(fabsf(INS.MotionAccel_n[1])<0.02f)
		{
		  INS.MotionAccel_n[1]=0.0f;	//y轴
		}
		if(fabsf(INS.MotionAccel_n[2])<0.04f)
		{
		  INS.MotionAccel_n[2]=0.0f;//z轴
			stop_time++;
		}
//		if(stop_time>10)
//		{//静止10ms
//		  stop_time=0;
//			INS.v_n=0.0f;
//		}

		if(ins_time>3000.0f)
		{
			INS.v_n=INS.v_n+INS.MotionAccel_n[1]*0.001f;
		  INS.x_n=INS.x_n+INS.v_n*0.001f;
			INS.ins_flag=1;//四元数基本收敛，加速度也基本收敛，可以开始底盘任务
			// 获取最终数据
          INS.Roll=mahony.roll;
		  INS.Pitch=mahony.pitch;
			INS.Yaw=mahony.yaw;

			if (INS.Yaw - INS.YawAngleLast > 3.1415926f)
			{
					INS.YawRoundCount--;
			}
			else if (INS.Yaw - INS.YawAngleLast < -3.1415926f)
			{
					INS.YawRoundCount++;
			}
			INS.YawTotalAngle = 6.283f* INS.YawRoundCount + INS.Yaw;
			INS.YawAngleLast = INS.Yaw;
		}
		else
		{
		 ins_time++;
		}

    osDelay(1);
	}
}


/**
 * @brief          Transform 3dvector from BodyFrame to EarthFrame
 * @param[1]       vector in BodyFrame
 * @param[2]       vector in EarthFrame
 * @param[3]       quaternion
 */
void BodyFrameToEarthFrame(const float *vecBF, float *vecEF, float *q)
{
    vecEF[0] = 2.0f * ((0.5f - q[2] * q[2] - q[3] * q[3]) * vecBF[0] +
                       (q[1] * q[2] - q[0] * q[3]) * vecBF[1] +
                       (q[1] * q[3] + q[0] * q[2]) * vecBF[2]);

    vecEF[1] = 2.0f * ((q[1] * q[2] + q[0] * q[3]) * vecBF[0] +
                       (0.5f - q[1] * q[1] - q[3] * q[3]) * vecBF[1] +
                       (q[2] * q[3] - q[0] * q[1]) * vecBF[2]);

    vecEF[2] = 2.0f * ((q[1] * q[3] - q[0] * q[2]) * vecBF[0] +
                       (q[2] * q[3] + q[0] * q[1]) * vecBF[1] +
                       (0.5f - q[1] * q[1] - q[2] * q[2]) * vecBF[2]);
}

/**
 * @brief          Transform 3dvector from EarthFrame to BodyFrame
 * @param[1]       vector in EarthFrame
 * @param[2]       vector in BodyFrame
 * @param[3]       quaternion
 */
void EarthFrameToBodyFrame(const float *vecEF, float *vecBF, float *q)
{
    vecBF[0] = 2.0f * ((0.5f - q[2] * q[2] - q[3] * q[3]) * vecEF[0] +
                       (q[1] * q[2] + q[0] * q[3]) * vecEF[1] +
                       (q[1] * q[3] - q[0] * q[2]) * vecEF[2]);

    vecBF[1] = 2.0f * ((q[1] * q[2] - q[0] * q[3]) * vecEF[0] +
                       (0.5f - q[1] * q[1] - q[3] * q[3]) * vecEF[1] +
                       (q[2] * q[3] + q[0] * q[1]) * vecEF[2]);

    vecBF[2] = 2.0f * ((q[1] * q[3] + q[0] * q[2]) * vecEF[0] +
                       (q[2] * q[3] - q[0] * q[1]) * vecEF[1] +
                       (0.5f - q[1] * q[1] - q[2] * q[2]) * vecEF[2]);
}
