hpzhaozhao/LZU_ASCENTO/lzu_ascento/Core/Inc/bmi088midware.h

//
// Created by Z on 26-1-1.
//

#ifndef BMI088MIDWARE_H
#define BMI088MIDWARE_H

#include "main.h"

#define BMI088_USE_SPI
//#define BMI088_USE_IIC

/*
#define CS1_ACCEL_GPIO_Port ACCEL_NSS_GPIO_Port
#define CS1_ACCEL_Pin ACCEL_NSS_Pin
#define CS1_GYRO_GPIO_Port GYRO_NSS_GPIO_Port
#define CS1_GYRO_Pin GYRO_NSS_Pin
*/

extern void BMI088_GPIO_init(void);
extern void BMI088_com_init(void);
extern void BMI088_delay_ms(uint16_t ms);
extern void BMI088_delay_us(uint16_t us);

#if defined(BMI088_USE_SPI)
extern void BMI088_ACCEL_NS_L(void);
extern void BMI088_ACCEL_NS_H(void);

extern void BMI088_GYRO_NS_L(void);
extern void BMI088_GYRO_NS_H(void);

extern uint8_t BMI088_read_write_byte(uint8_t reg);

extern SPI_HandleTypeDef *BMI088_SPI;

#elif defined(BMI088_USE_IIC)

#endif

#endif
