hpzhaozhao/LZU_ASCENTO/lzu_ascento/Core/Inc/can_bsp.h

//
// Created by Z on 25-12-29.
//

#ifndef CAN_BSP_H
#define CAN_BSP_H

#include "main.h"

typedef FDCAN_HandleTypeDef hcan_t;

extern void FDCAN1_Config(void);
extern void FDCAN2_Config(void);
extern uint8_t canx_send_data(FDCAN_HandleTypeDef *hcan, uint16_t id, uint8_t *data, uint32_t len);



#endif //CAN_BSP_H
