hpzhaozhao/LZU_ASCENTO/(commit log)

2026-06-19 Add leg structure diagram and length ratios
    Added a diagram of the leg structure with length ratios to the README.
2026-06-19 Revise README with motor selection and debugging notes
    Updated the README to include additional details on motor selection, code debugging, and project timeline.
